donut-hole0/rc-int-arm-rover/(list of files, cad)

Other CAD files:
mechanical/arm/Rover Robotic Arm (8-15-2026).f3d
mechanical/final/RC Rover Base Body Final.f3d
mechanical/final/Rover Robotic Arm Final.f3d
mechanical/rover/RC Rover Base Body (8-15-2026).f3d
