donut-hole0/rc-int-arm-rover/electrical/exports/rover_schem.pdf

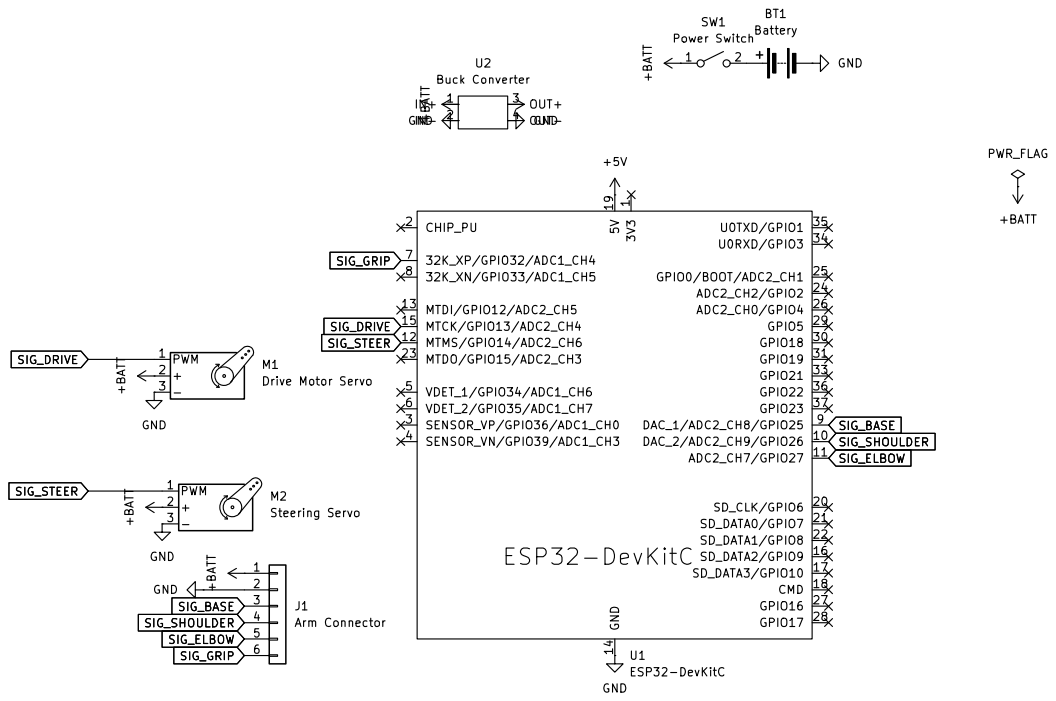
[picture p1: page 1]
