donut-hole0/rc-int-arm-rover/electrical/kicad/rc_rover.kicad_sch

## KiCad design electrical/kicad/rc_rover.kicad_sch (2026-08-15)

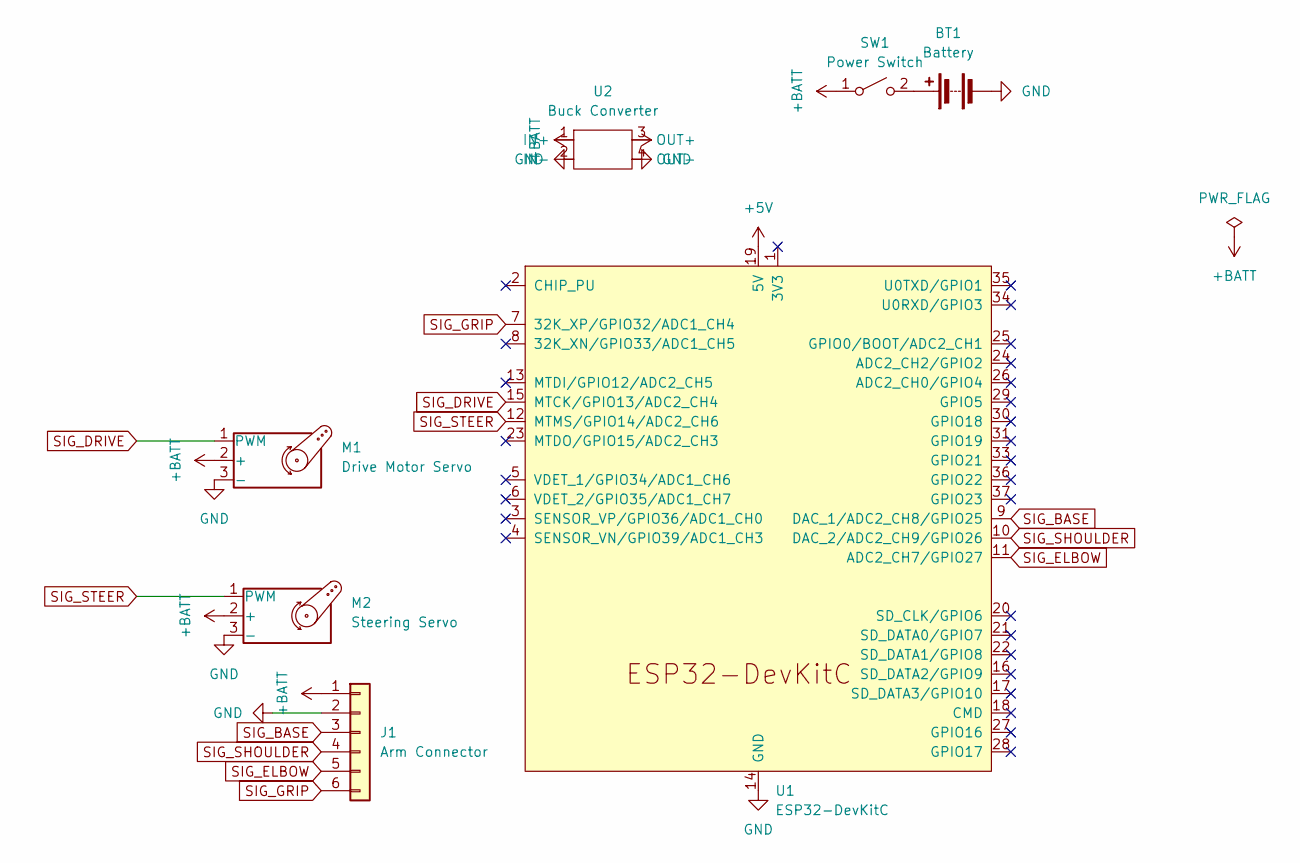
[picture p2: schematic rc_rover.kicad_sch]

Parts:
BT1: Battery
J1: Arm Connector
M1: Drive Motor Servo
M2: Steering Servo
SW1: Power Switch
U1: ESP32-DevKitC
U2: Buck Converter

Connections:
+5V: U1.19 (5V), U2.3 (OUT+)
+BATT: J1.1, M1.2 (+), M2.2 (+), SW1.1 (A), U2.1 (IN+)
GND: BT1.2 (-), J1.2, M1.3 (-), M2.3 (-), U1.14 (GND), U1.32 (GND), U1.38 (GND), U2.2 (IN-), U2.4 (OUT-)
unnamed: BT1.1 (+), SW1.2 (B)
SIG_BASE: J1.3, U1.9 (DAC_1/ADC2_CH8/GPIO25)
SIG_DRIVE: M1.1 (PWM), U1.15 (MTCK/GPIO13/ADC2_CH4)
SIG_ELBOW: J1.5, U1.11 (ADC2_CH7/GPIO27)
SIG_GRIP: J1.6, U1.7 (32K_XP/GPIO32/ADC1_CH4)
SIG_SHOULDER: J1.4, U1.10 (DAC_2/ADC2_CH9/GPIO26)
SIG_STEER: M2.1 (PWM), U1.12 (MTMS/GPIO14/ADC2_CH6)
