donut-hole0/rc-int-arm-rover/electrical/kicad/rc_rover_controller.kicad_sch

## KiCad design electrical/kicad/rc_rover_controller.kicad_sch (2026-10-26)

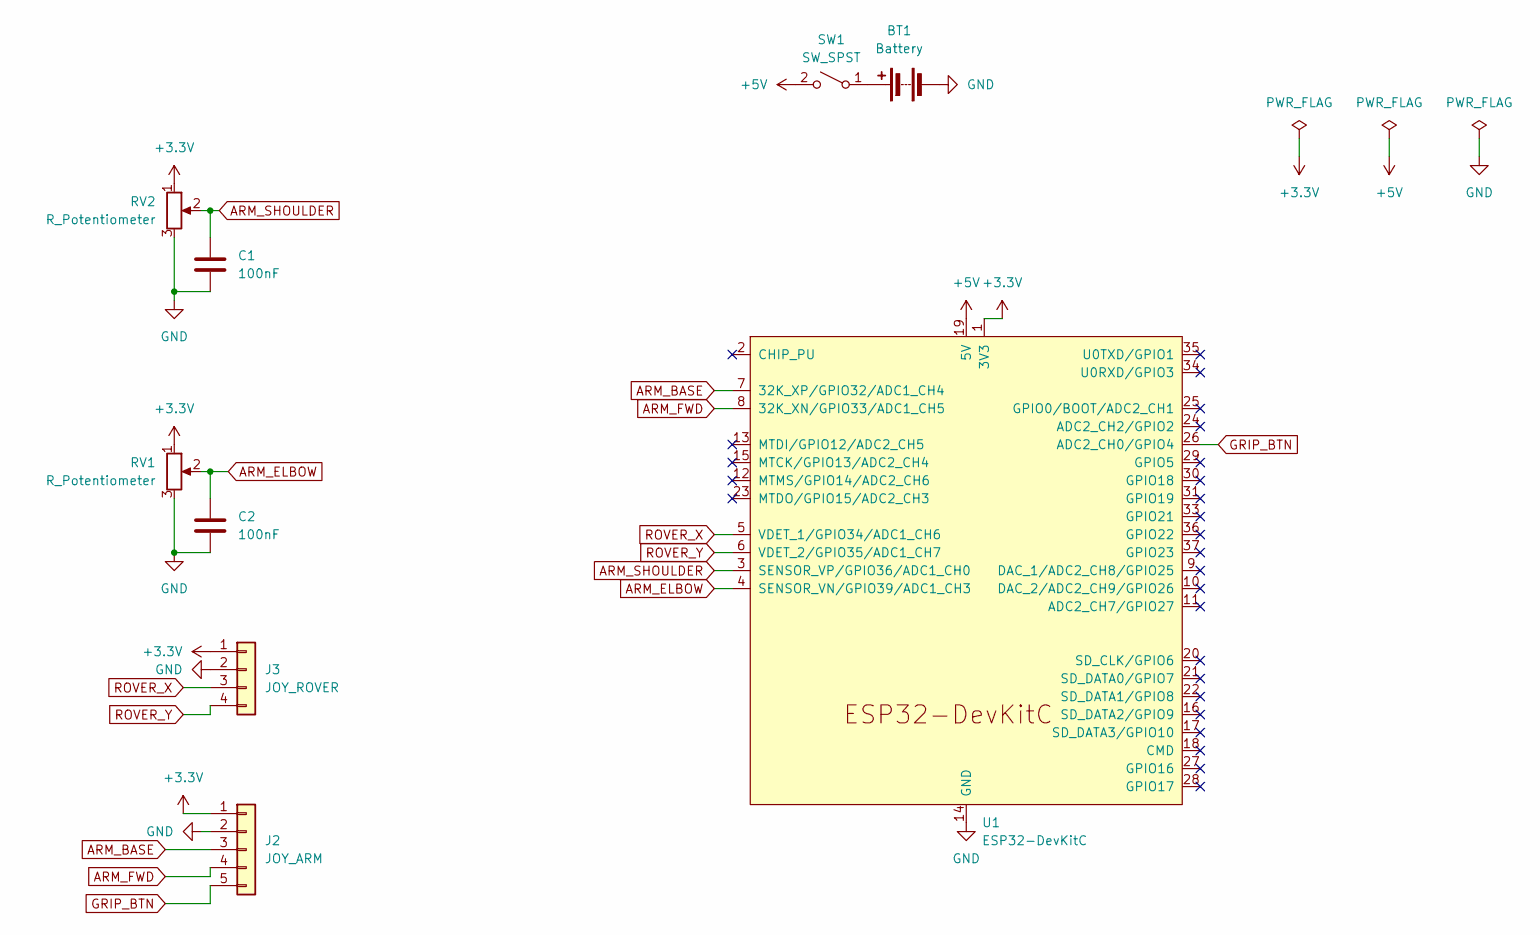
[picture p3: schematic rc_rover_controller.kicad_sch]

Parts:
BT1: Battery
C1, C2: 100nF
J2: JOY_ARM
J3: JOY_ROVER
RV1, RV2: R_Potentiometer
SW1: SW_SPST
U1: ESP32-DevKitC

Connections:
+3.3V: J2.1, J3.1, RV1.1, RV2.1, U1.1 (3V3)
+5V: SW1.2 (B), U1.19 (5V)
ARM_BASE: J2.3, U1.7 (32K_XP/GPIO32/ADC1_CH4)
ARM_ELBOW: C2.1, RV1.2, U1.4 (SENSOR_VN/GPIO39/ADC1_CH3)
ARM_FWD: J2.4, U1.8 (32K_XN/GPIO33/ADC1_CH5)
ARM_SHOULDER: C1.1, RV2.2, U1.3 (SENSOR_VP/GPIO36/ADC1_CH0)
GND: BT1.2 (-), C1.2, C2.2, J2.2, J3.2, RV1.3, RV2.3, U1.14 (GND), U1.32 (GND), U1.38 (GND)
GRIP_BTN: J2.5, U1.26 (ADC2_CH0/GPIO4)
unnamed: BT1.1 (+), SW1.1 (A)
ROVER_X: J3.3, U1.5 (VDET_1/GPIO34/ADC1_CH6)
ROVER_Y: J3.4, U1.6 (VDET_2/GPIO35/ADC1_CH7)
