donut-hole0/rc-int-arm-rover/(commit log)

2026-08-15 Robotic arm progress snapshot as of 8/15/2026
    Completed first draft, will print and test with mg90s servos to see if any changes need to be made to the model.
    [Rover Robotic Arm (8-15-2026).f3d]
2026-08-15 Snapshot of Rover Body Progress as of 8/15/2026
    Need to finish the turning mechanism and a few finishing touches on the rest of the body before printing.
    [RC Rover Base Body (8-15-2026).f3d]
2026-10-26 Rename rc_rover.kicad_sch
    [rc_rover.kicad_sch]
2026-10-26 finished controller schematic
2026-10-26 Uploaded ESP32 rover and controller scripts
2026-10-27 Uploaded Rover and Robotic Arm Files
    [RC Rover Base Body Final.f3d, Rover Robotic Arm Final.f3d]
2026-10-31 Create README.md for WiFi RC Rover with Robotic Arm
    Add detailed README for WiFi RC Rover project
